amithadadm-zoref/ball-and-beam-pid/Recorded data explained.docx

pid_data_1784821454.csv - 23.07.2026

The controller is now performing well across the board.

Tracking quality (settled)

Setpoint | Settled at | Std (jitter) | SS error | Verdict
15 cm | 15.4 | 0.38 | −0.4 | Excellent
20 cm | 20.0 | 0.53 | 0.0 | Excellent
22 cm | 21.5 | 0.66 | +0.5 | Very good
26 cm | 25.9–26.3 | 0.93 | ±0.3 | Very good
29 cm | 24.6 | 1.96 | +4.4 | Unreachable ❌

Key findings

1. The 20 cm setpoint is now tight (std 0.53) — previously it was your worst spot at std 1.3–1.9. Whatever changed (firmware tweak / power fix) resolved the mid-range looseness. Big improvement.
2. Steady-state error is near-zero everywhere reachable (≤0.5 cm) — integral term is solid.
3. 29 cm is physically unreachable. The ball tops out at 28.9 cm all run. When you commanded 29, it settled at 24.6 with a +4.4 cm error, and you can see the classic signature in the timeline:
  - [3816] dist=23.8 sp=29.1 srv=125 kp=6.60 — servo pinned near max (125–130), gain scheduling ramped kp up to 6.6, but the ball can't get there.
  - This is also most of your 7% servo-rail time — it's all from that unreachable-setpoint episode, not from oscillation.
4. Sensor-check mode is visible in the data: 4% of rows have setpoint=0 and servo=90 (the Mode 1 startup default you just set). That's expected — those are the moments before you switched to PID control.

Bottom line

Reachable range is ~15–28 cm and within it you're holding sub-cm steady-state error with std under 1 cm. That's a well-tuned, working ball-and-beam controller. The only "problem" is commanding 29 cm, which is beyond the beam's physical reach — cap the slider at 28 and you'll never hit that wall.

pid_data_1787826197.csv – 27.08.2026

there was a previous run this day that I set the Kp to be 10. This was a better run.

Yes — you're right, this run is better. The key difference: you dropped kp back to 6 (Kp_eff maxes at 6.6, not 11).

This run vs. the previous one

Metric | Previous (kp≈10) | This run (kp=6)
Servo at rails | 12% | 3% ✅
Kp_eff range | 4.2–11.0 | 4.2–6.6
Big SS errors (−2.9, −3.2) | yes ❌ | gone (all ≤0.7) ✅

Settling quality

Setpoint | Settled | Std | SS error
15 cm | 14.8–14.9 | 0.90 | +0.1 ✅
20 cm | 20.5 | 0.84 | −0.5 ✅
25 cm | 25.1 | 1.98 | −0.1
20 cm (2nd) | 20.7 | 2.08 | −0.7

Why it's better: lowering kp to 6 stopped the over-driving — the servo no longer slams into the rails (3% vs 12%), and the steady-state offsets that plagued the last run are gone. Steady-state accuracy is now excellent everywhere (≤0.7 cm).

Remaining wart: the 25 cm hold and one 20 cm hold are jittery (std ~2) while 15 cm is tight (0.9). That mid/high-range looseness is the same spot you've seen before — likely IR-sensor nonlinearity or a slightly soft derivative there. If you want to chase it, try nudging kd up (4 → 5) or ALPHA_DERIVATIVE down (0.7 → 0.5) for more smoothing — but honestly this is already a solid controller.

Takeaway: keep base kp = 6. That's your sweet spot — the kp≈10 experiment was a step backward.
