amithadadm-zoref/ball-and-beam-pid/(commit log)

2026-09-27 Delete pid_data_1787826197.csv
    Same file with more informative name will be uploaded
    [pid_data_1787826197.csv]
2026-09-27 Add files via upload
    PID loop demonstration of multiple requested positions
